OzmoOzmo/CastleHKCArduinoRKP/Docs/IMG_2826.JPG

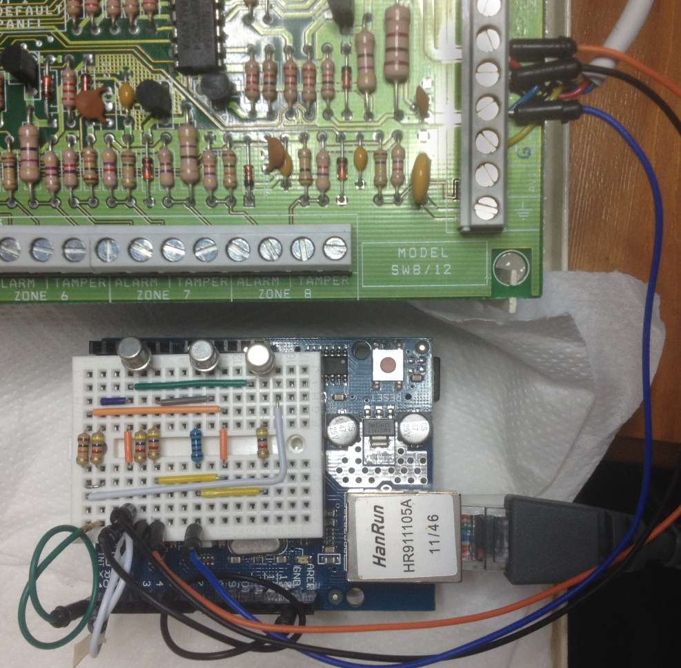
Docs/IMG_2826.JPG
