OzmoOzmo/CastleHKCArduinoRKP/Docs/CircuitDiagram.png

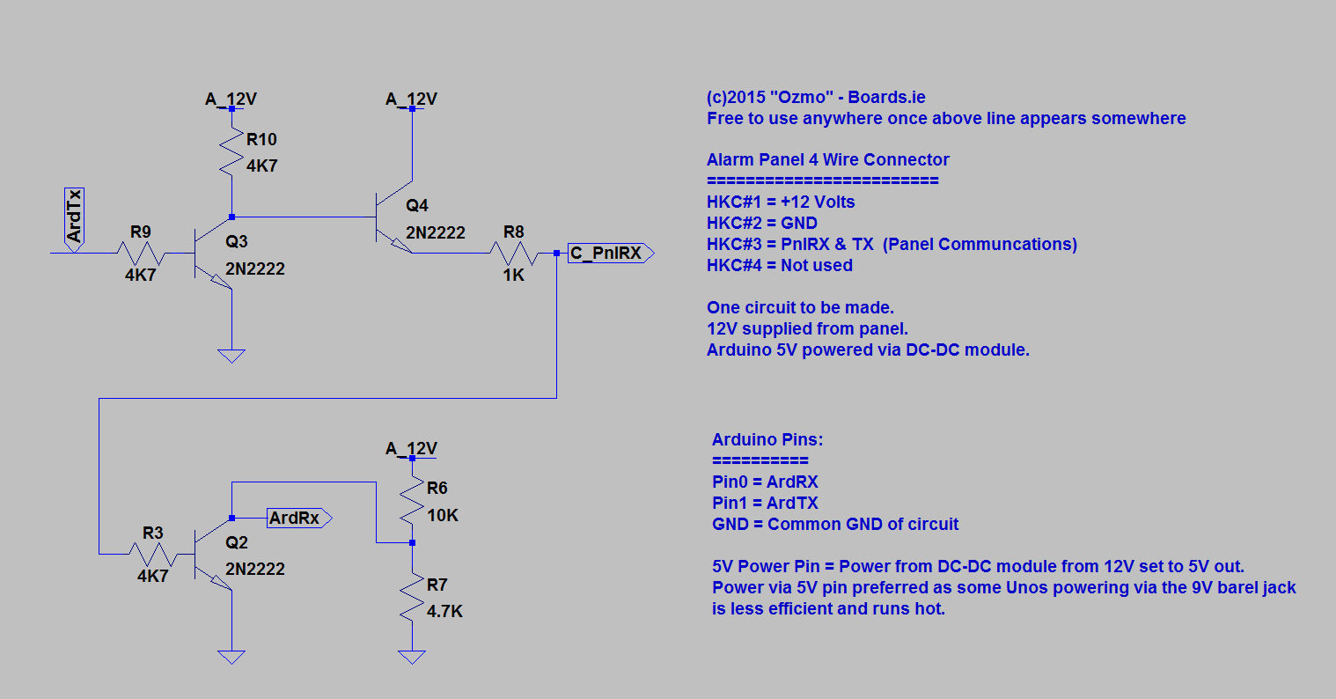
Docs/CircuitDiagram.png
