OzmoOzmo/CastleHKCArduinoRKP/Docs/HKC remote access.png

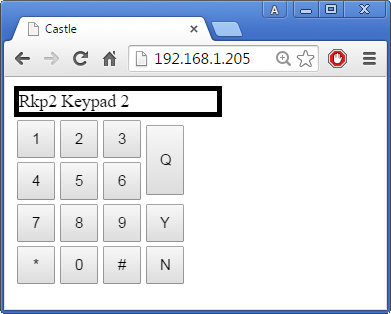
Docs/HKC remote access.png
