OzmoOzmo/CastleHKCArduinoRKP/Docs/ArdTx Final Soln V2_CustomLib.asc

0-5V: signal; PULSE(0 5 0 .000001 .000001 .0006 .0012 100)
0-12V: signal; PULSE(0 12 0 .000001 .000001 0.0006 .0012 10000)
C1: cap; 10nF
Q2: npn; BC109C
Q3: NPN; BC109C
Q4: NPN; BC109C
R3: res; 4K7; tol=1 pwr=0.1
R4: res; 2K; tol=1 pwr=0.1
R6: res; 10K; tol=1 pwr=0.1
R7: res; 4.7K; tol=1 pwr=0.1
R8: res; 1K; tol=1 pwr=0.1
R9: res; 4K7; tol=1 pwr=0.1
R10: res; 4K7; tol=1 pwr=0.1
V1: voltage; 12V
V2: voltage; 5V
Named nets: A_12V, 0, ArdTx, D_PnlTx, ArdRx, C_PnlRX, 5V, B_0V
.tran 10m startup
Line Resistance
(c)2015 "Ozmo" - Boards.ie
Free to use anywhere once above line appears somewhere
 
Alarm Panel 4 Wire Connector
========================
HKC#1 = +12 Volts
HKC#2 = GND
HKC#3 = PnlRX & TX  (Panel Communcations)
HKC#4 = Not used
 
One circuit to be made.
12V supplied from panel. 
Arduino 5V powered via DC-DC module.
Arduino Pins:
==========
Pin0 = ArdRX
Pin1 = ArdTX
GND = Common GND of circuit
 
5V Power Pin = Power from DC-DC module from 12V set to 5V out.
Power via 5V pin preferred as some Unos powering via the 9V barel jack 
is less efficient and runs hot.
