OzmoOzmo/CastleHKCArduinoRKP/CastleHKCArduinoRKP/Config.h

/*
 * Config.h
 *
 *
 *	This is all you should need edit to get a working system
 *
 *   Aritech Alarm Panel Arduino Internet Enabled Keypad -  CS350 - CD34 - CD72 - CD91 and more
 *
 *   For Arduino (UNO or Leonardo) with added Ethernet Shield
 *
 *   See Circuit Diagram for wiring instructions
 *
 *   Author: Ozmo
 *
 *   See: http://www.boards.ie/vbulletin/showthread.php?p=88215184
 *
*/

//--------Configuration Start----------

#ifndef CONFIG_H_  //Dont touch
#define CONFIG_H_  //Dont touch


//The Arduino IP address and Port (192.168.1.205:8383)
#define IP_A 192
#define IP_B 168
#define IP_C 1
#define IP_D 205
//The IPPort for the server to listen on
#define IP_P 8383


#define EMAIL_ADDR "---@gmail.com"  //Email to send to

#define USE_SMTP_PASSWORD                 //comment this out if your SMTP server doesnt need to logon before sending emails (eg. your ISP smtp server wont need login)
#define SMTP_USER "---@gmx.com"           //SMTP account name to send from (www.gmx.com is a good option)
#define SMTP_PASS "---pass here---"       //SMTP account password to send from


//Set to 1 for normal operation - comment out will debug print useful logs - Only Useful for Leonardo
#define QUIET 1  //NOTE - For Arduino UNO - THIS MUST BE DEFINED (as we need the only Serial port for panel comms)

//Build Version (displayed on webpage)
#define sVersion "V4.00"

#define SENDEMAILS 1      //Define this to enable sending emails - Comment line out to disable sending emails


//The Email server
//This is the IP for "smtp.gmx.com" a free smtp server you can use
// smtp.gmx.com = 74.208.5.1
#define SMTP_IP_A 74
#define SMTP_IP_B 208
#define SMTP_IP_C 5
#define SMTP_IP_D 1


/*---To Send emails You NEED get the IP address of the SMTP server from the list below that matches your Internet Provider
  No DNS lookup as Ive removed that from my libs to save space...

smtp.mysmart.ie							Smart Telecom Outgoing SMTP Server
smtp.irishbroadband.ie.					Irish Broadband Outgoing SMTP Server
mail1.eircom.net OR mail2.eircom.net	Eircom Outgoing SMTP Server
smtp.magnet.ie							Magnet Outgoing SMTP Server
smtp.upcmail.ie							NTL and UPC Outgoing SMTP Server
mail.icecomms.net						Ice Broadband Outgoing SMTP Server
mail.vodafone.ie						Vodafone Outgoing SMTP Server
smtp.o2.ie								O2 Outgoing SMTP Server
smtp.clearwire.ie / mail.clearwire.ie	Clearwire Outgoing SMTP Server
smtp.digiweb.ie							Digiweb Outgoing SMTP Server
mail.imagine.ie OR mail.gaelic.ie		Imagine Broadband Outgoing SMTP Server
mail.perlico.ie							Perlico Outgoing SMTP Server
mail-relay.3ireland.ie					3 Outgoing SMTP Server: Mobile broadband with 3 mobile Ireland
*/


#endif /* CONFIG_H_ */
