OzmoOzmo/CastleHKCArduinoRKP/(commit log)

2015-06-08 Beta version of the HKC keypad emulator
    Working - can scan for keypad and the arduino gets accepted as a hck
    keypad.
    Webpage works and you can work through a browser as if you were on the
    keypad.
    You can arm set and enter engeneer menus etc.
    Not implemented yet: no email functionality and no warning when alarm
    goes off.
2017-03-27 Update RKP.cpp
    Fix to only send alarm email on "Always-On Red LED" and not a blinking Red led - which indicates a non alarm state "Partset Active".
    [RKP.cpp]
